32200362-sys/real/markers/marker_10_CUP.png

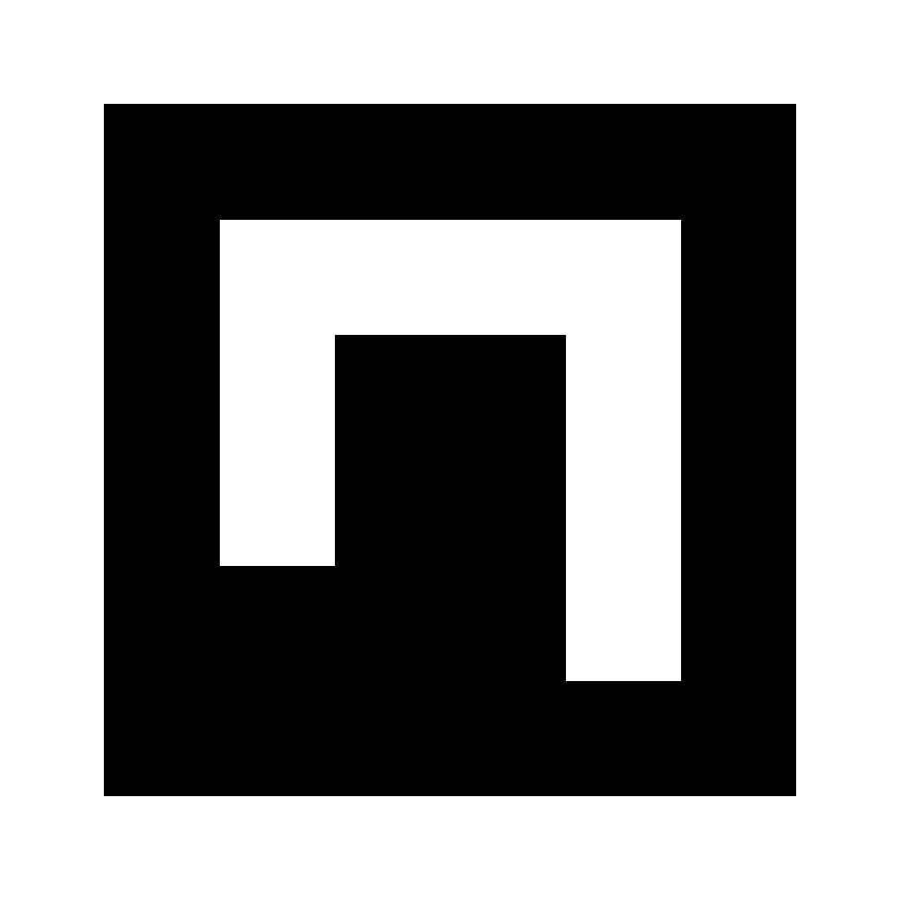
markers/marker_10_CUP.png
