32200362-sys/real/markers/marker_20_COASTER.png

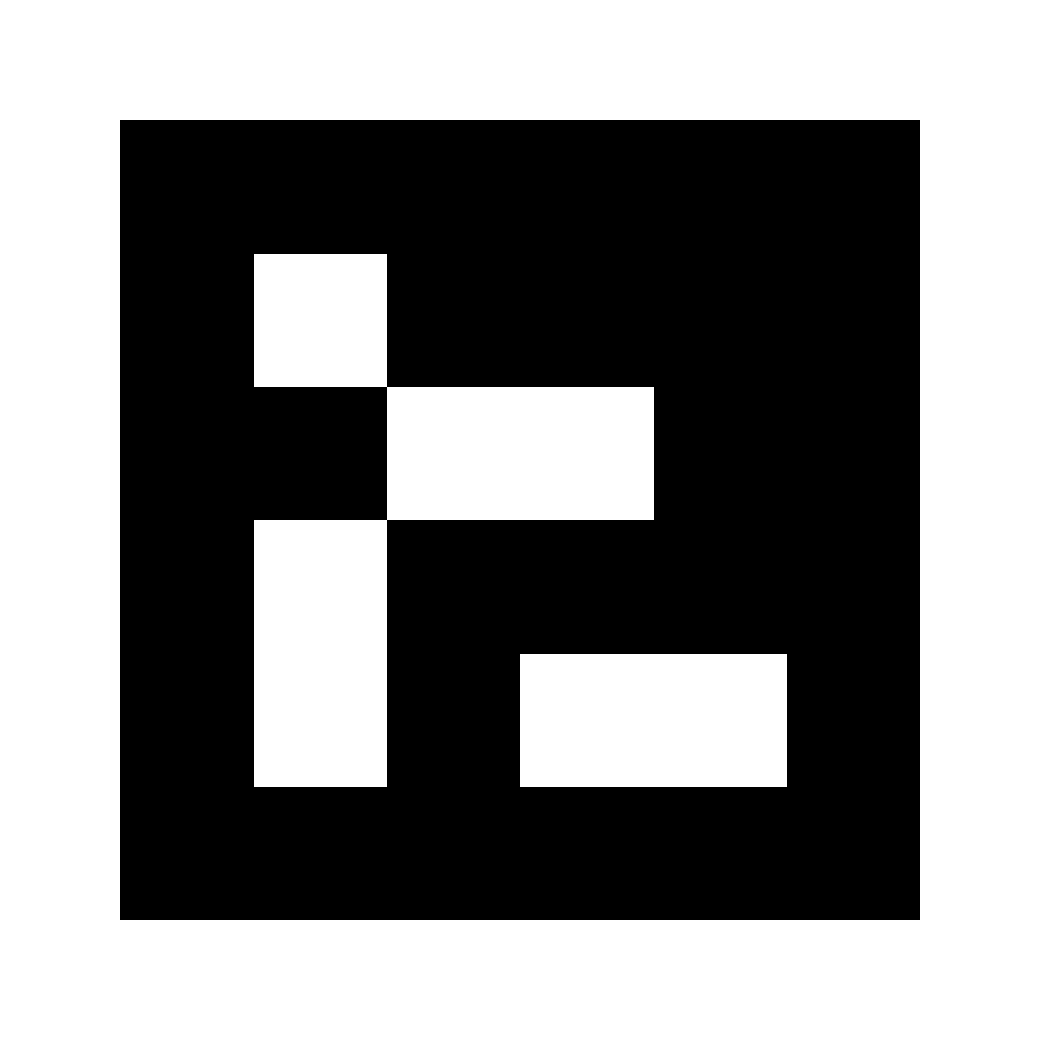
markers/marker_20_COASTER.png
