32200362-sys/real/markers/marker_30_LAPTOP.png

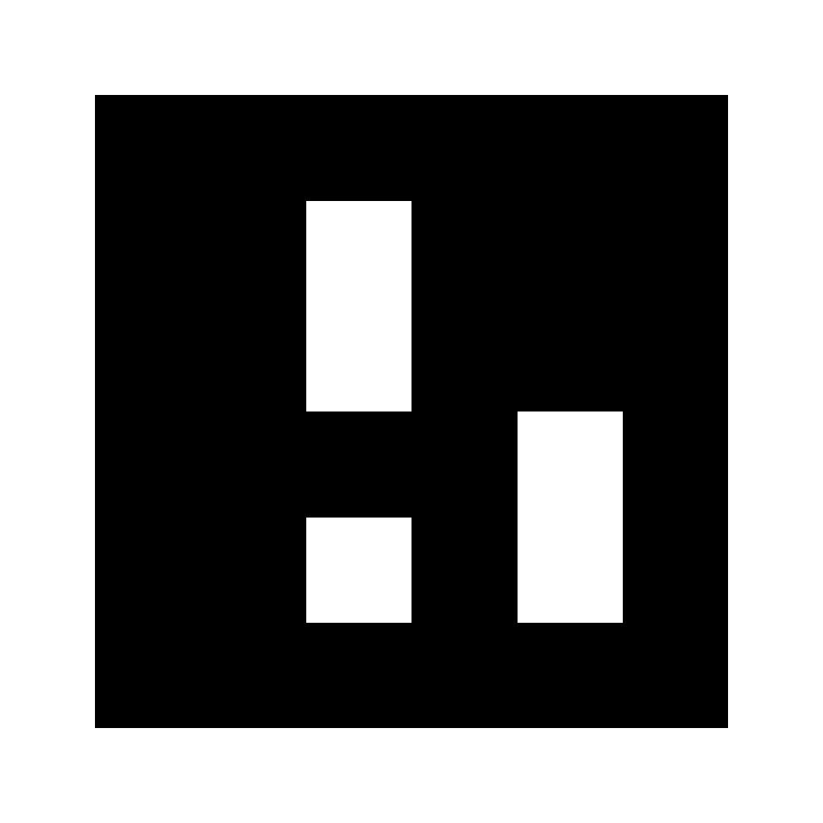
markers/marker_30_LAPTOP.png
