32200362-sys/real/markers/marker_40_PAPER.png

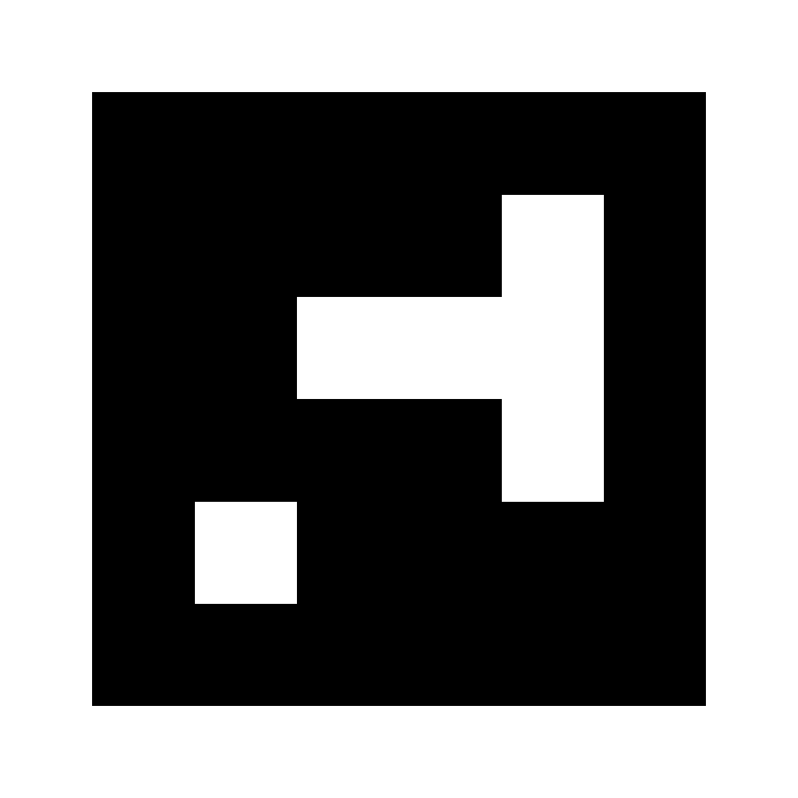
markers/marker_40_PAPER.png
