32200362-sys/real/(commit log)

2026-10-02 Add smart coaster AI pipeline with ESP32 omni controller firmware
    - Laptop-side AI: YOLO cup + MediaPipe pose/hands + ArUco coaster,
    risk scoring, state machine, avoidance/return planner
    - ESP32 link: typed JSON UDP sender (cm/s, marker-heading aware),
    telemetry listener, ARM/STOP/reset keys and status overlay
    - ESP32 firmware (esp32/esp32_omni_controller) with feed-forward
    extrapolation fix beyond the 15 cm/s LUT boundary
    - Link test script, tests, and docs
2026-10-02 Match marker IDs, add AI debug log to ESP32 serial monitor
    - Use configurable coaster/cup marker IDs (0=robot, 1=cup) instead of
    hardcoded 20/10 in pipeline and session logger
    - Send AI state/behavior/risk as optional "dbg" field; firmware prints
    received commands to serial (rate limited) with LOG ON/OFF command
    - Firmware: disable Wi-Fi power save, larger serial TX buffer,
    expose motionStateLabel
    - Point settings.yaml at the current ESP32 address
2026-10-02 Fix avoidance never triggering: hand-only fallback, HOLD priority, marker hold
    - Use the hand nearest to the cup when no pose/arm is matched
    (vision.hand_only_fallback)
    - COLLISION_RISK now overrides HOLD, and short REACHING flicker between
    collision frames no longer resets the avoid counter
    (state.avoid_grace_frames)
    - Hold the last coaster/cup marker for vision.marker_hold_s to bridge
    1-4 frame detection dropouts
    - Add tests for the fallback, flicker handling and marker hold
    [settings.yaml]
